AcheronProject/MadHatter/README.md

# Acheron Alice-SM-S-STM32-MX-TH-WI (Codename "Mad Hatter")

Acheron Logo

See [this page](https://gondolindrim.github.io/AcheronDocs/madhatter/intro.html) for the Mad Hatter documentation.

## Introduction

The Mad Hatter is an Alice-layout compatible PCB, originally designed by Raphael Faria for the Lubrigante keyboard. Originally it was an Atmega32U4-powered PCB, using USB mini connector and with no per-key lighting support.

It is currently under redesign by Gondolindrim to use STM32F072CBT6 microprocessor and RGB per-key lighting.

## Contributors

- [Raphael Faria](https://github.com/raphaelfaria), who was the designer of the first version of the Mad Hatter PCB. His version is available as the [Omicron release](https://github.com/Gondolindrim/mad-hatter/releases/tag/Omicron). 

<!--
## Supported layouts

Click [this link](http://www.keyboard-layout-editor.com/#/gists/73be427d3e8086a9253feece2dae6974) for the KLE file for the Arctic.

![Arctic layouts](https://github.com/Gondolindrim/ArcticPCB/raw/master/graphics/KLE/arcticKLE.png)

## Renders

Click at the images to zoom in.

Renders generated by the [tracespace.io](https://tracespace.io/view/) site.

![ArcticPCB Top Render](https://github.com/Gondolindrim/ArcticPCB/raw/master/graphics/renders/topRender.png)

![ArcticPCB Bottom Render](https://github.com/Gondolindrim/ArcticPCB/raw/master/graphics/renders/bottomRender.png)
-->

## Icon

The Mad Hatter Logo was made using the  [Alice in Wonderland font](https://www.dafont.com/pt/alice-in-wonderland.font) with slight modifications.

## Copyright notice

This project is released under the Acheron Open-Hardware License V1.2. For the license, please refer to the LICENCE.md file.
