AcheronProject/MadHatter/graphics/mad_hatter_label.png

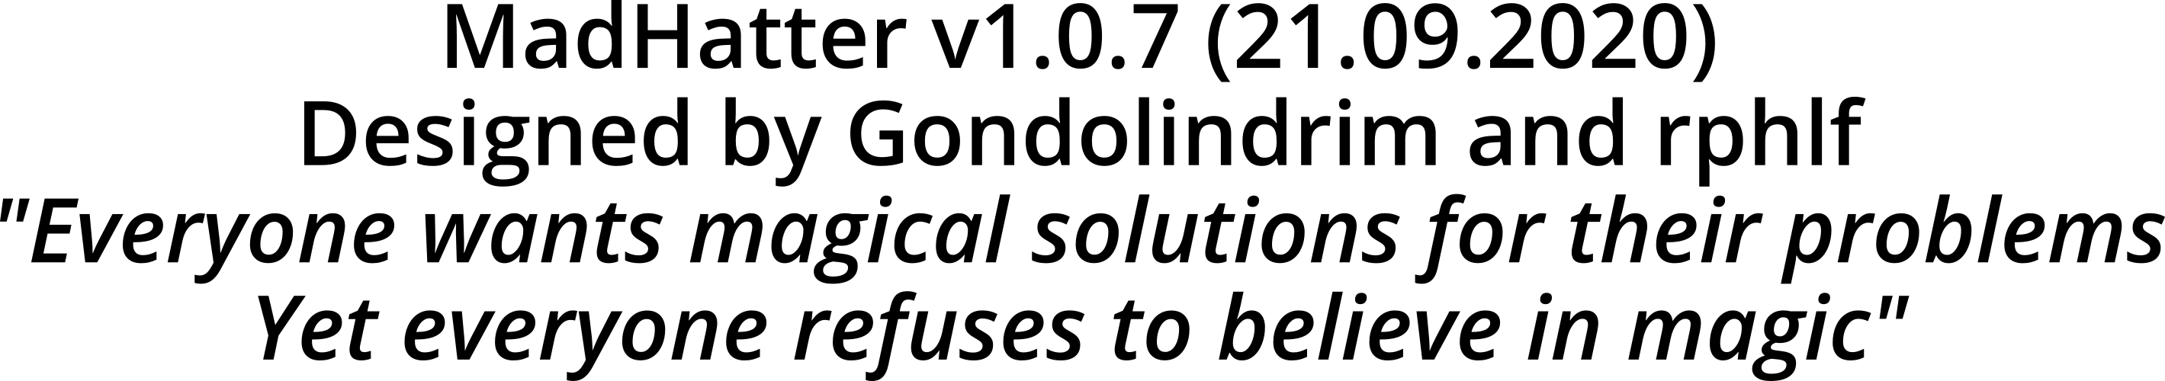
graphics/mad_hatter_label.png
