AcheronProject/MadHatter/(commit log)

2020-03-20 Cleanup chores
    - Organized folders and files into graphics/ and kicadFiles/ folders;
    - Clean up indicator LEDs area and removed the Edge.Cuts layer slots;
    - Added Mad Hatter logo;
    [mad-hatter.kicad_pcb, mad-hatter.sch]
2020-03-20 Move Dwgs.User segments to Eco2.User
    [mad-hatter.kicad_pcb]
2020-03-21 Placed RGB LEDs
    [mad-hatter.kicad_pcb, mad-hatter.sch]
2020-03-28 Further developments
    - Placed some capacitors for the RGBs
    - Introduced rotary encoders
    - Added indicator LEDs resistors
    - Rounded corners of the PCB
    [mad-hatter.kicad_pcb, mad-hatter.sch]
2020-07-10 Update library, remove unused files
    [mad-hatter.kicad_sch, mad-hatter.sch]
2020-07-10 Place RGB matrix symbols, place first row on PCB
    [mad-hatter.kicad_pcb, mad-hatter.kicad_sch]
2020-07-10 Place second RGB row
    [mad-hatter.kicad_pcb]
2020-07-10 Place third RGB row
    [mad-hatter.kicad_pcb]
2020-07-11 Route first row and part of ISSI chip
    [mad-hatter.kicad_pcb, mad-hatter.kicad_sch]
2020-07-11 Route most of the RGBs
    [mad-hatter.kicad_pcb, mad-hatter.kicad_sch]
2020-07-12 Route RGB rows, start routing columns
    [mad-hatter.kicad_pcb, mad-hatter.kicad_sch]
2020-07-15 Routed right side
    [mad-hatter.kicad_sch]
2020-07-16 Route USB circuit. Descriptive fields pending
    [mad-hatter.kicad_sch]
2020-07-16 Add OSH and Acheron logos, add MCU fills
    [mad-hatter.kicad_sch]
2020-07-16 Route ley columns
    [mad-hatter.kicad_sch]
2020-07-16 Routed RGB power lines
    [mad-hatter.kicad_sch]
2020-07-16 Route indicator lights
    [mad-hatter.kicad_sch]
2020-07-24 Finish routing, DRC and release pending
    [mad-hatter.kicad_sch]
2020-07-24 Expose MCU extra pins
    [mad-hatter.kicad_sch]
2020-07-24 Organized schematic
    [mad-hatter.kicad_sch]
2020-07-24 Fixed silkscreen designators issues
2020-07-24 Change encoder debout resistors to 0805
    [mad-hatter.kicad_sch]
2020-08-03 Add V1.0 label
    [mad-hatter.kicad_sch]
2020-08-03 Fix manufacturer part number field in several components. Connect unconnected pads
    [mad-hatter.kicad_sch]
2020-08-03 DRC ran
    [mad-hatter.kicad_sch]
2020-08-03 Fill missing fields from several components and organized fab layers
    [mad-hatter.kicad_sch]
2020-08-03 Preparing for v1.0.5 release
    [mad-hatter.kicad_sch]
2020-08-03 Fixing some components fields
    [mad-hatter.kicad_sch]
2020-08-27 Quality updates
    - Added a double-layer USBC footprint such that the USBC conenctor can be soldered in any of the two layers
    - Changed the reset circuit BOOT0 values for more reliable values
    - Added label source SVG file
    [mad-hatter.kicad_sch]
2020-09-21 QOL improvements
    - Better screw hole posts cutouts-
    - Removed bumps to accomodate for indicator LED pads; PCB edges now cut through the pads
    [mad-hatter.kicad_sch]
